LPRDev/PoolSkimmer/images/100_7558.jpg

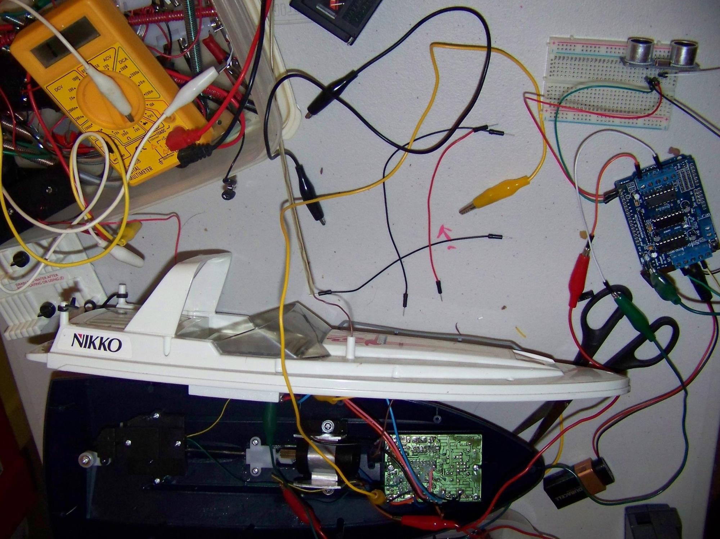
images/100_7558.jpg
