LPRDev/PoolSkimmer/images/100_7559.jpg

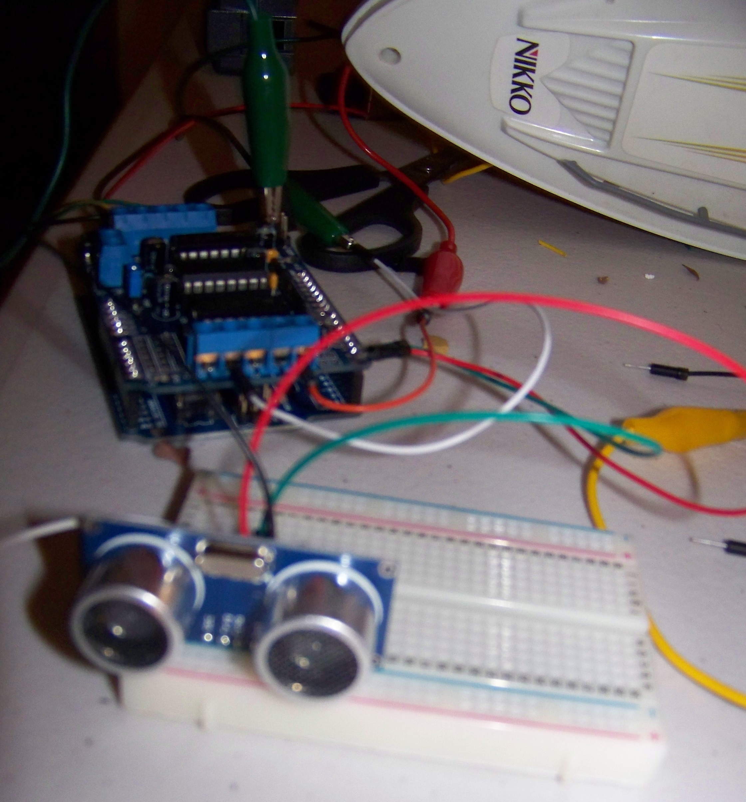
images/100_7559.jpg
