LPRDev/PoolSkimmer/images/100_7560.jpg

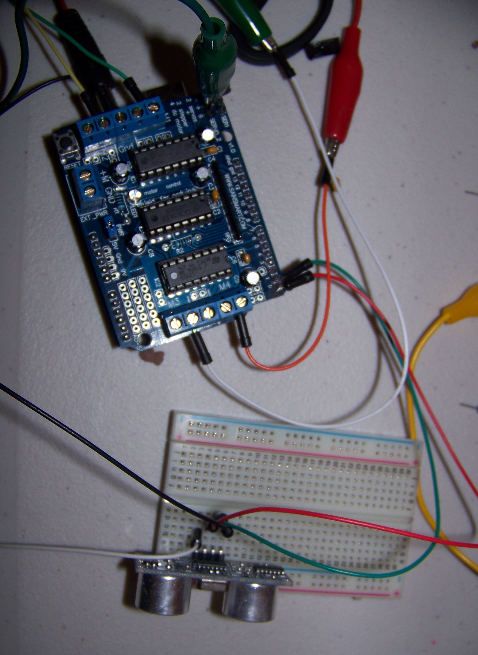
images/100_7560.jpg
