LPRDev/PoolSkimmer/(commit log)

2016-12-30 Pool Skimmer Arduino Files
    Code for arduino controller. Includes cpp and h files for motorshiled
    and Ultrasonic.
2016-12-31 Wiring diagram
    original wiring diagram
2017-01-03 Update README.md
    Added details for wiring.
